skiselev/Proton_Turbo_XT/KiCad/Proton_Turbo_XT-Schematic-1.0.pdf

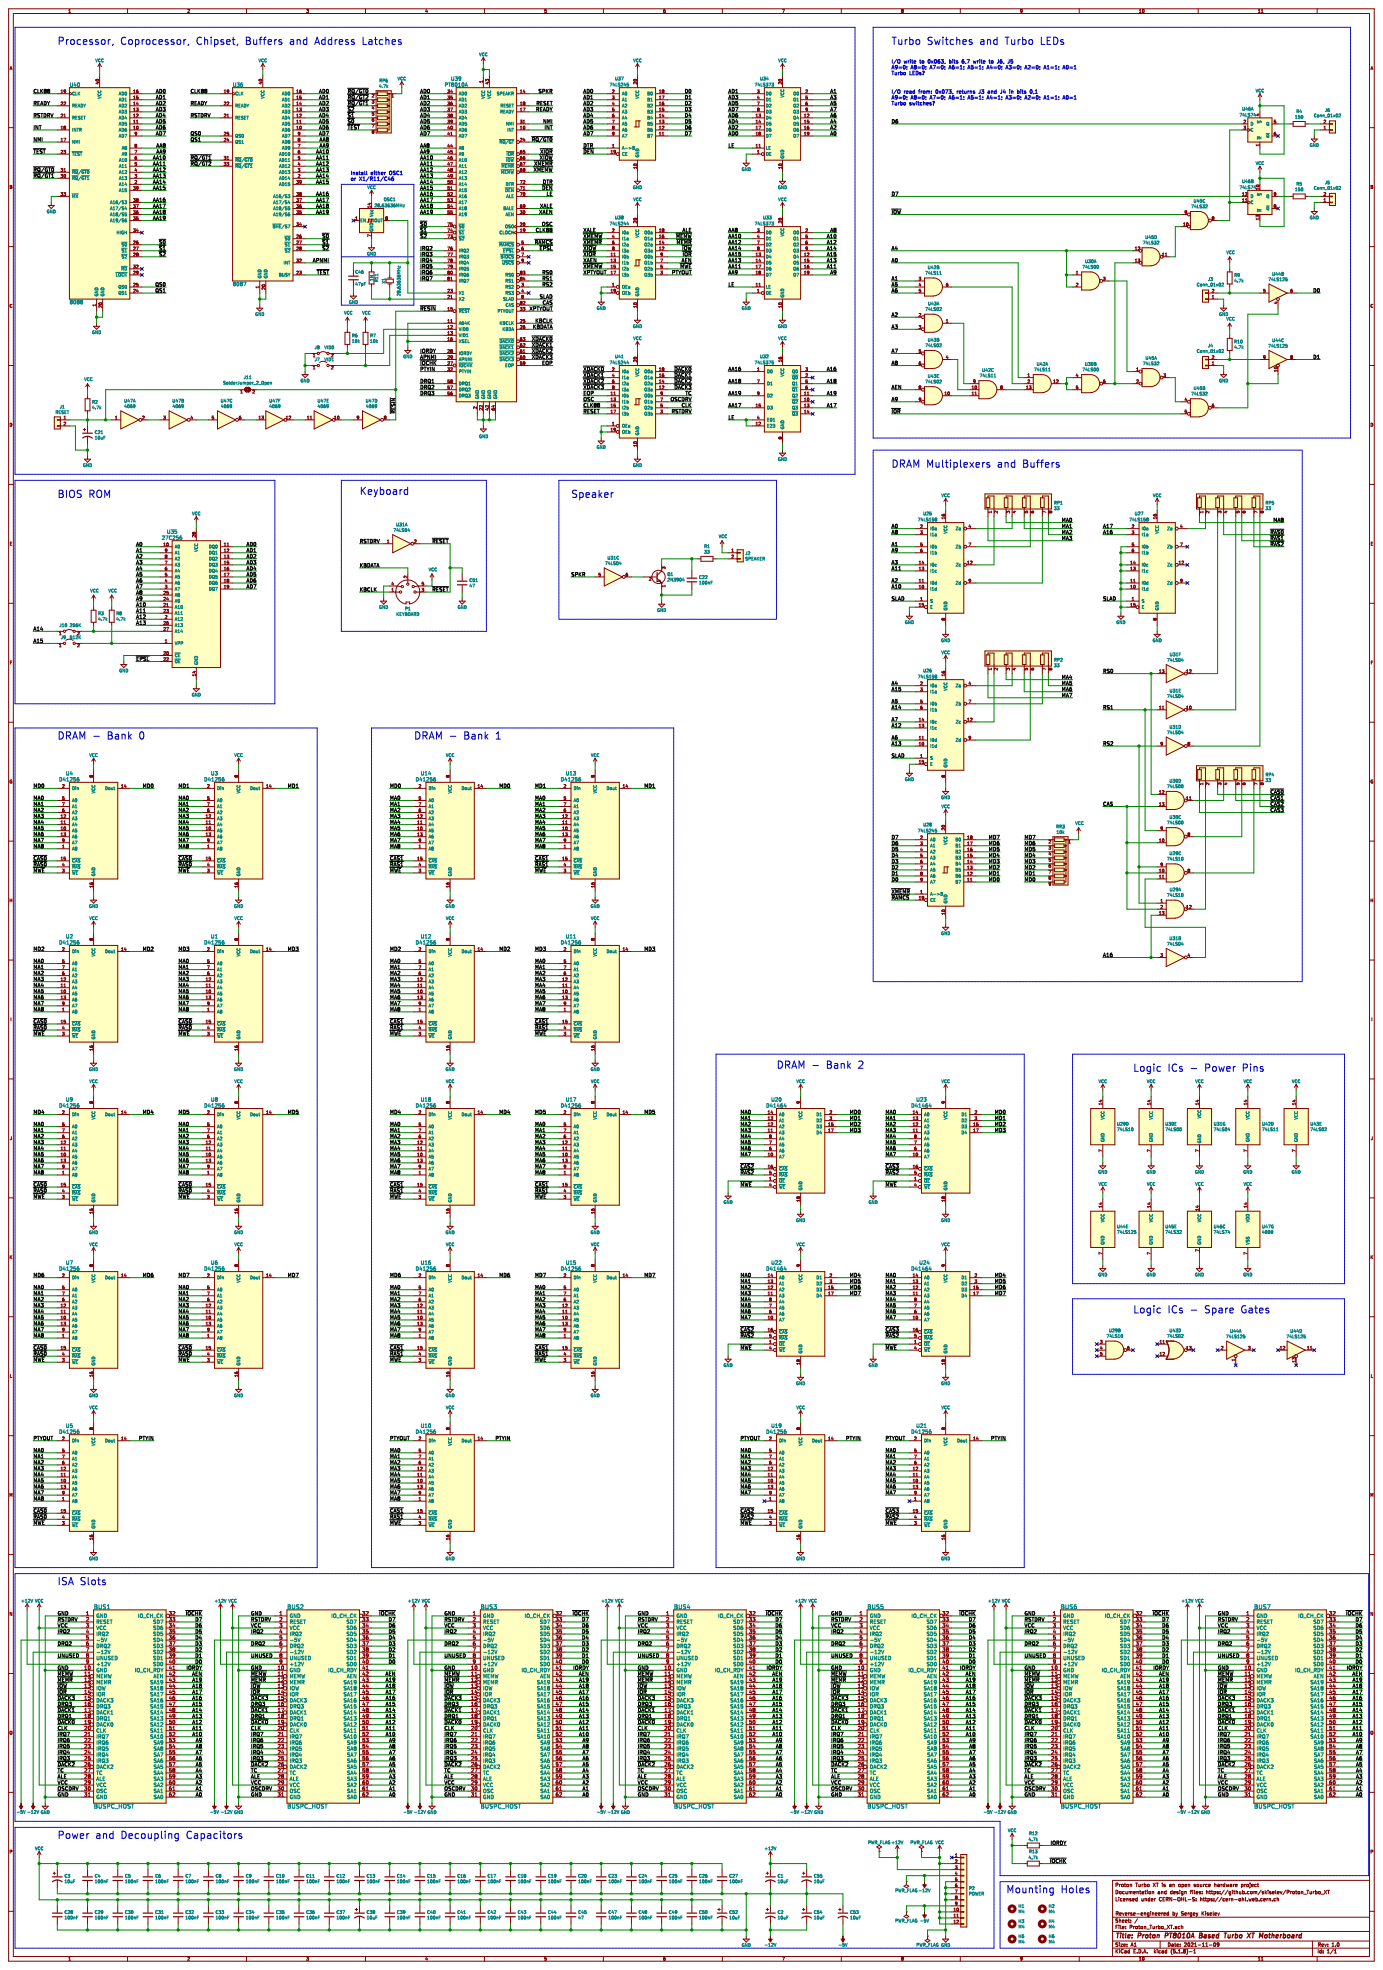
[picture p2: page 1]
