skiselev/Proton_Turbo_XT/KiCad/Proton_Turbo_XT.sch

## KiCad design KiCad/Proton_Turbo_XT.sch (2021-11-10)

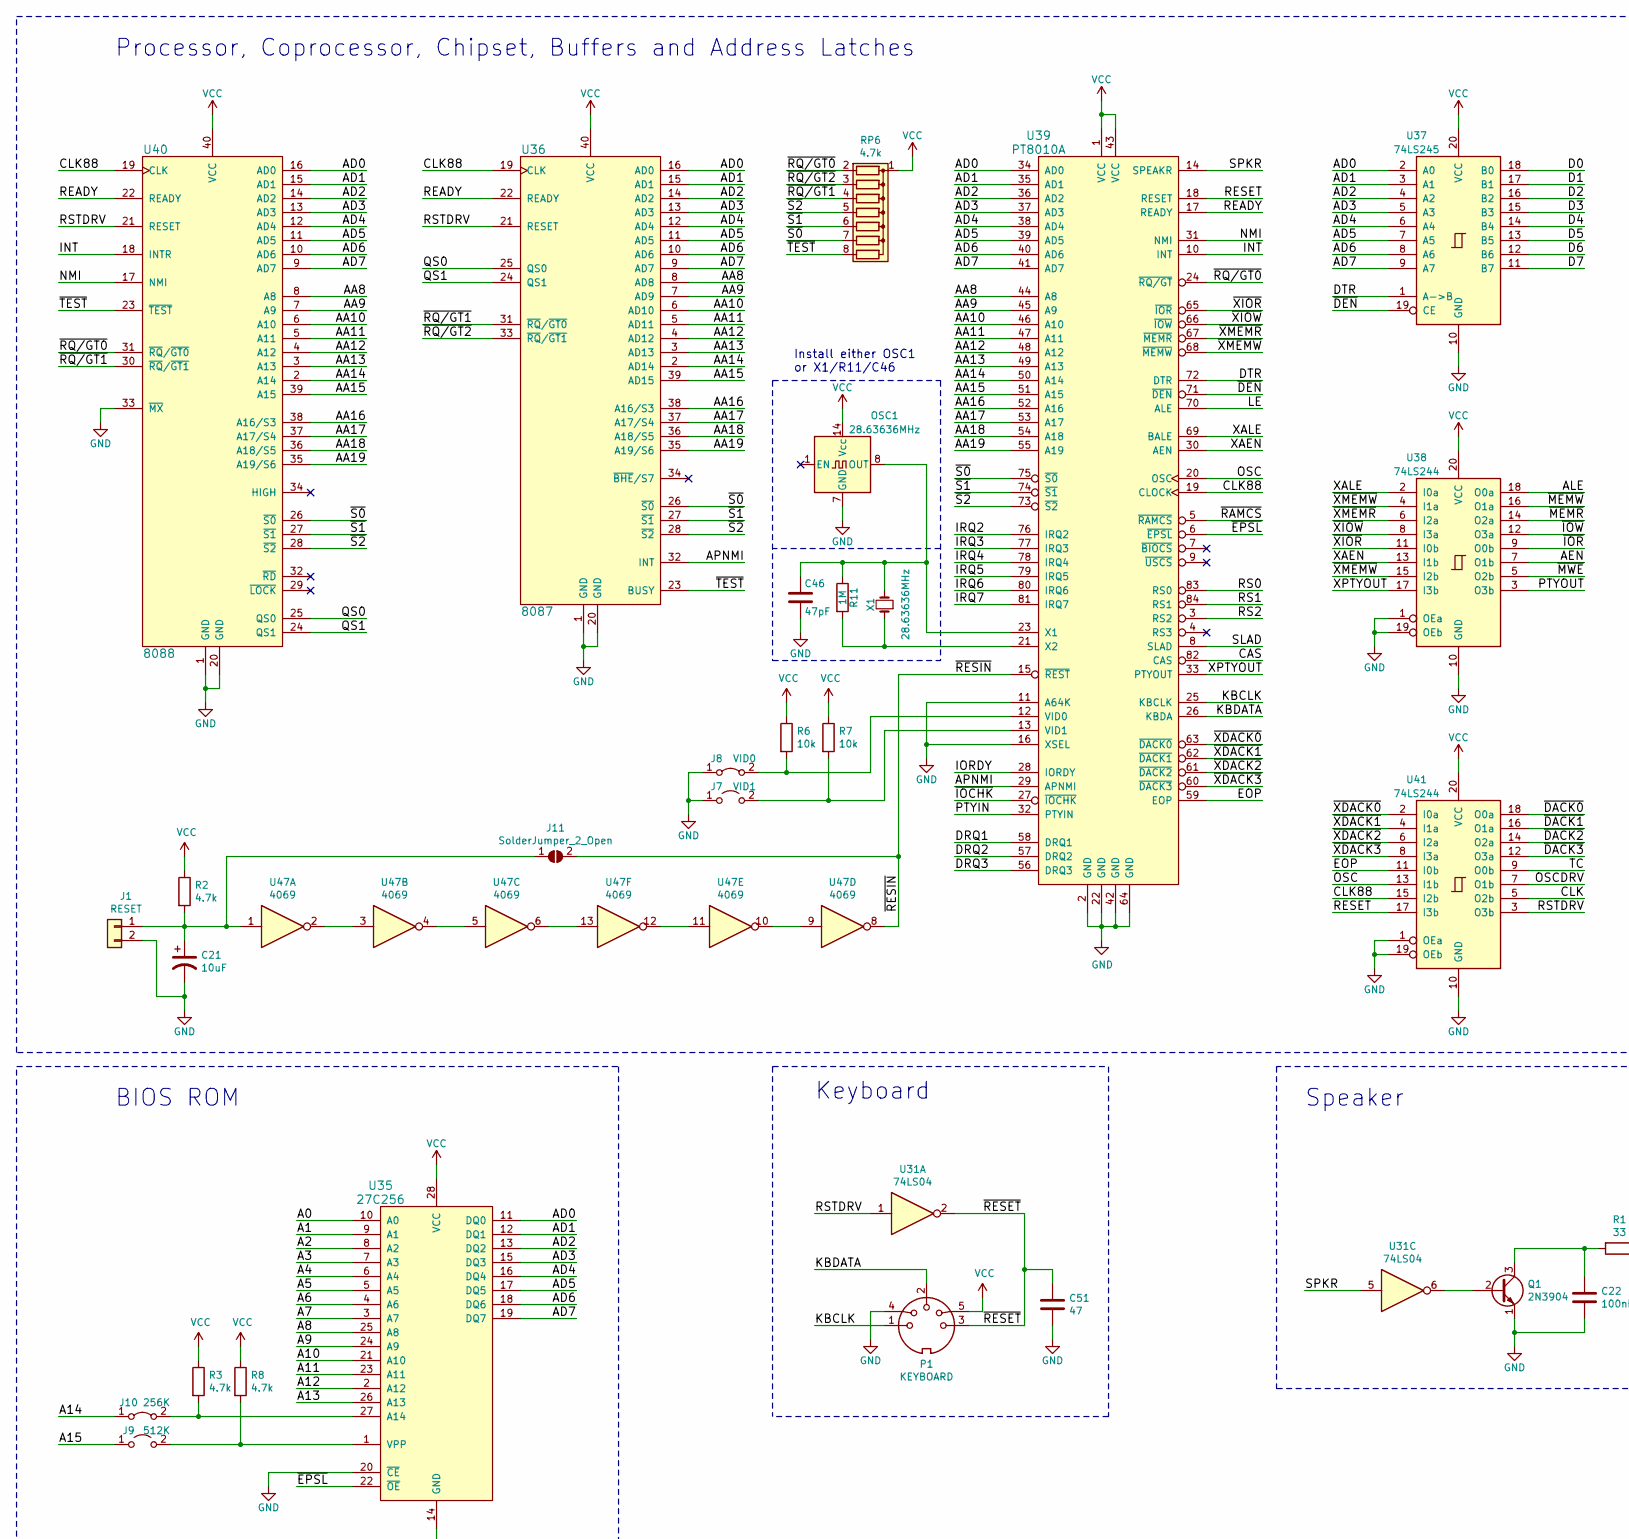
[picture p3: schematic Proton_Turbo_XT.sch, part in row 1, column 1]

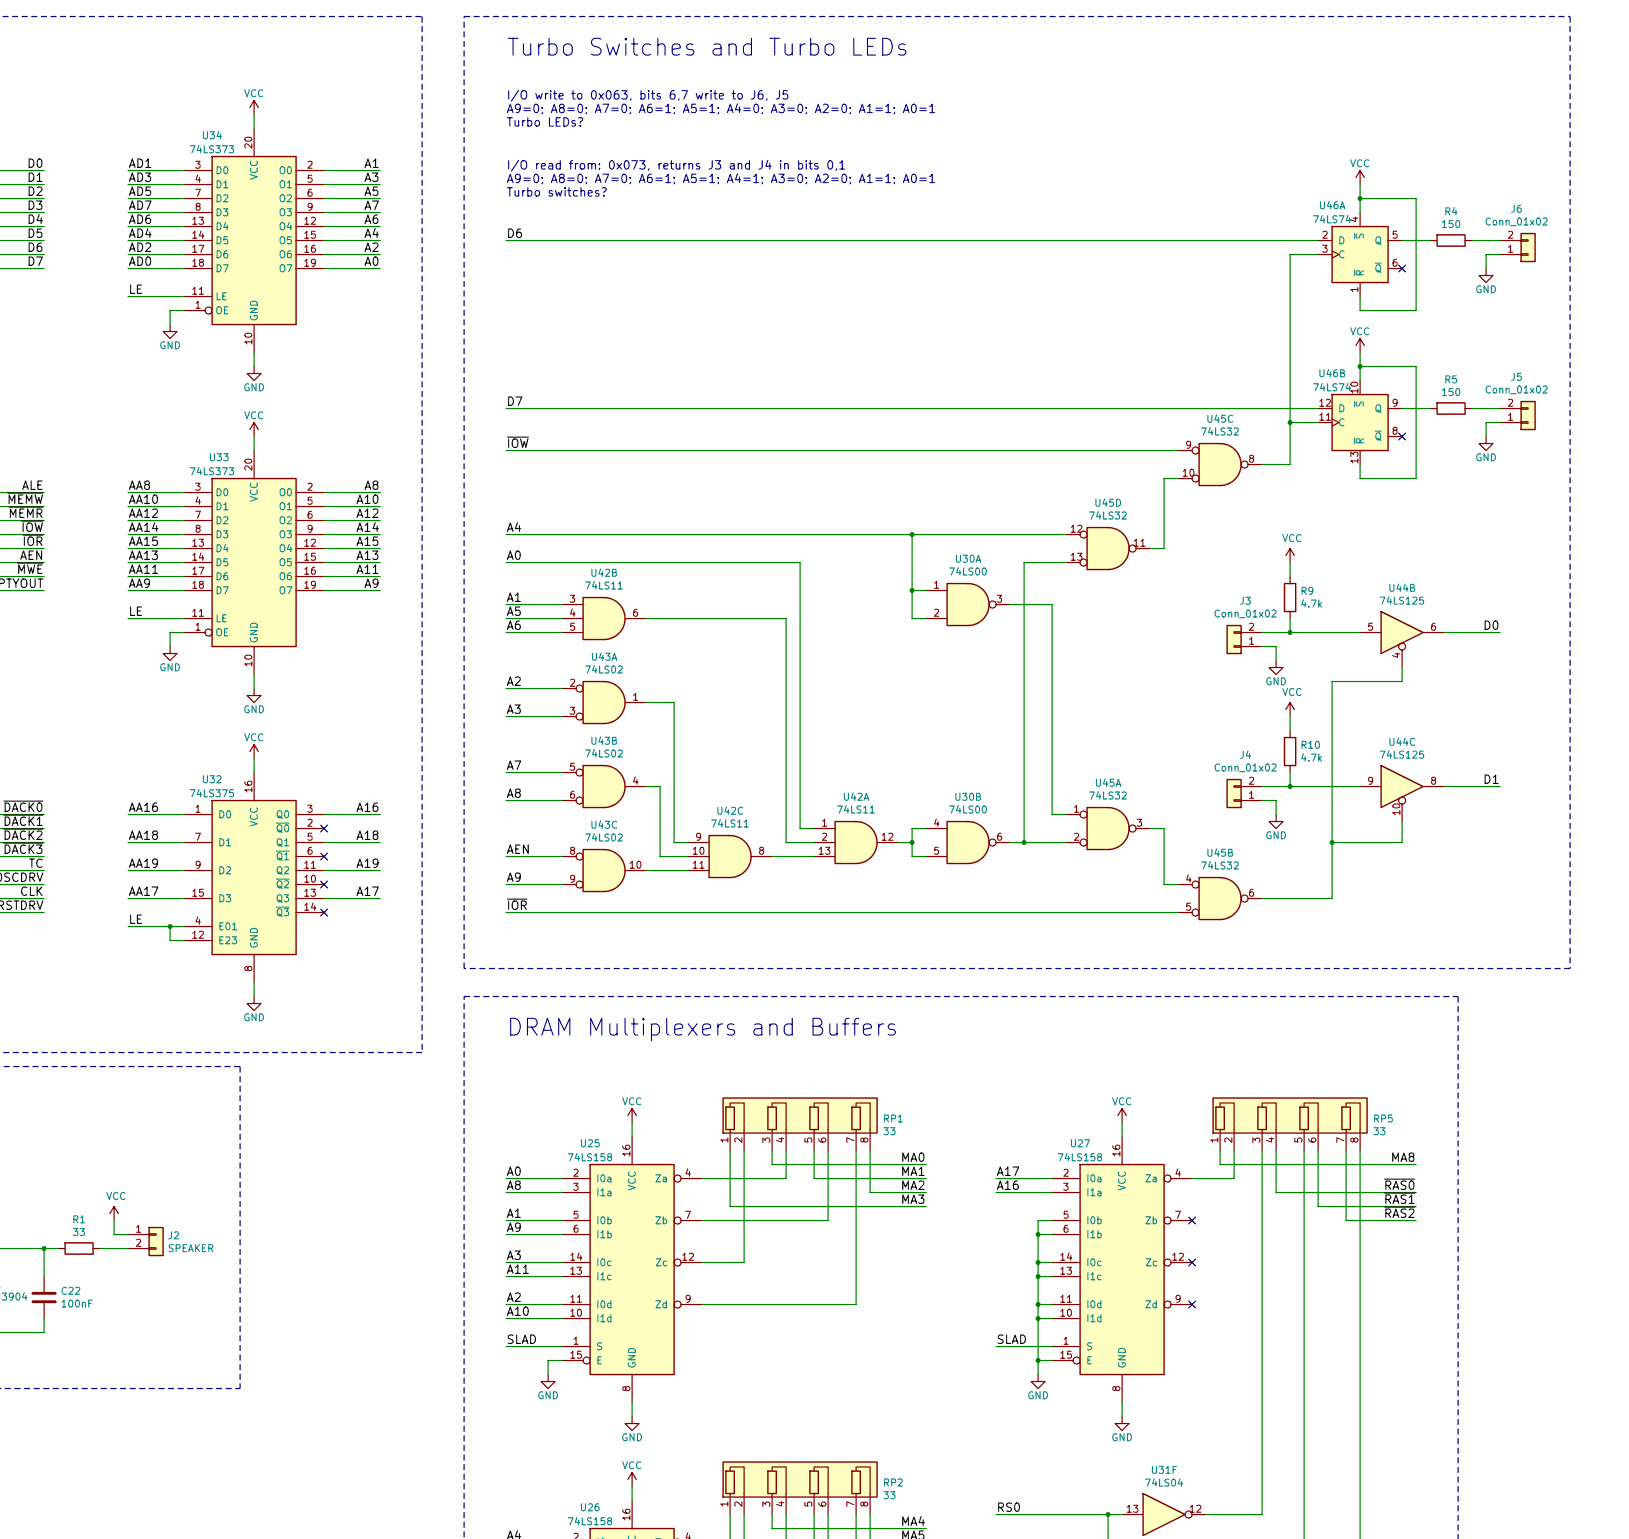
[picture p4: schematic Proton_Turbo_XT.sch, part in row 1, column 2]

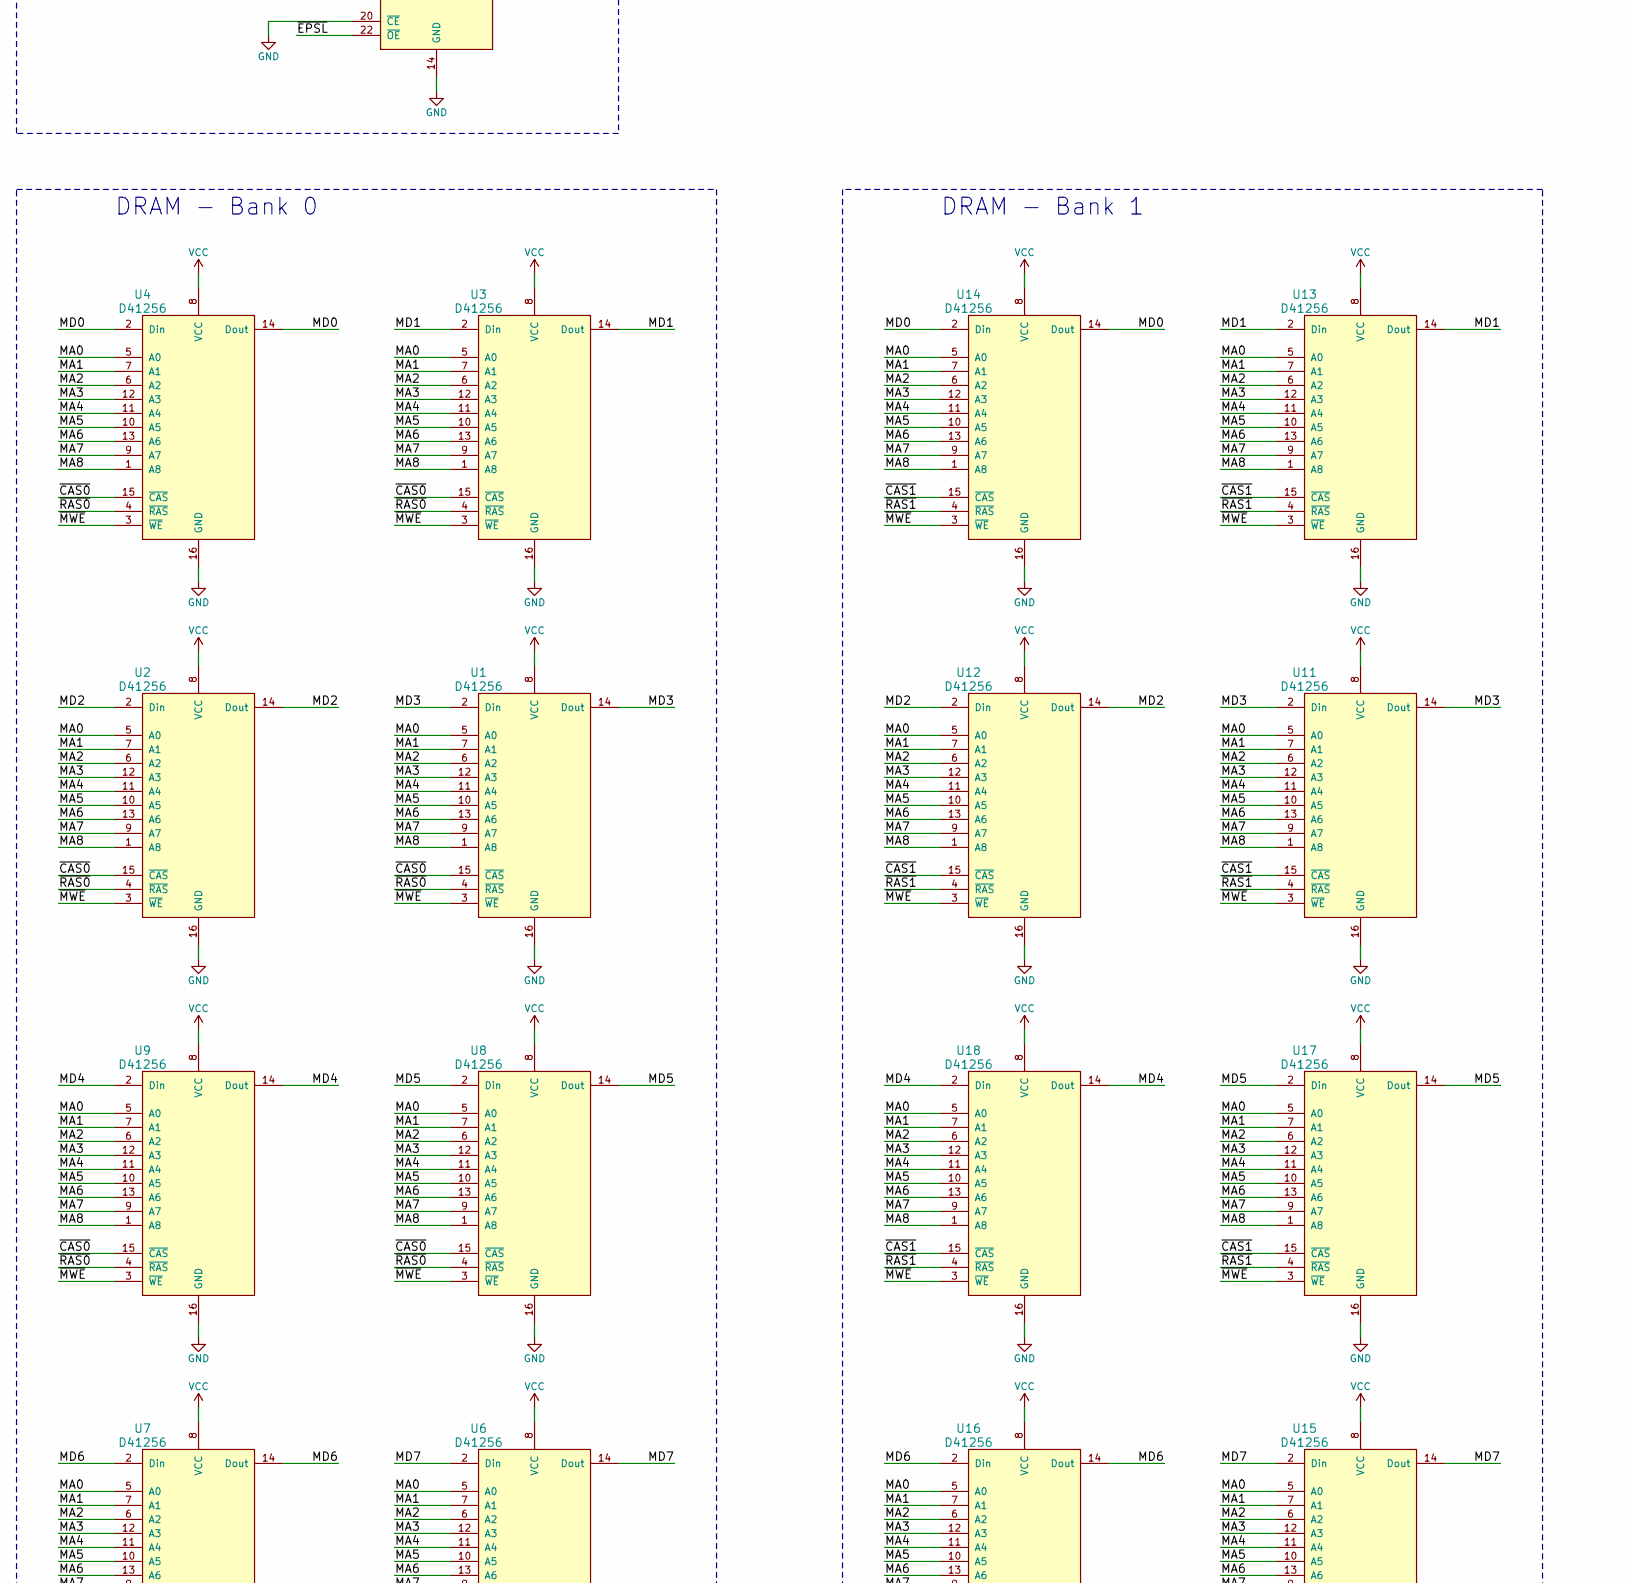
[picture p5: schematic Proton_Turbo_XT.sch, part in row 2, column 1]

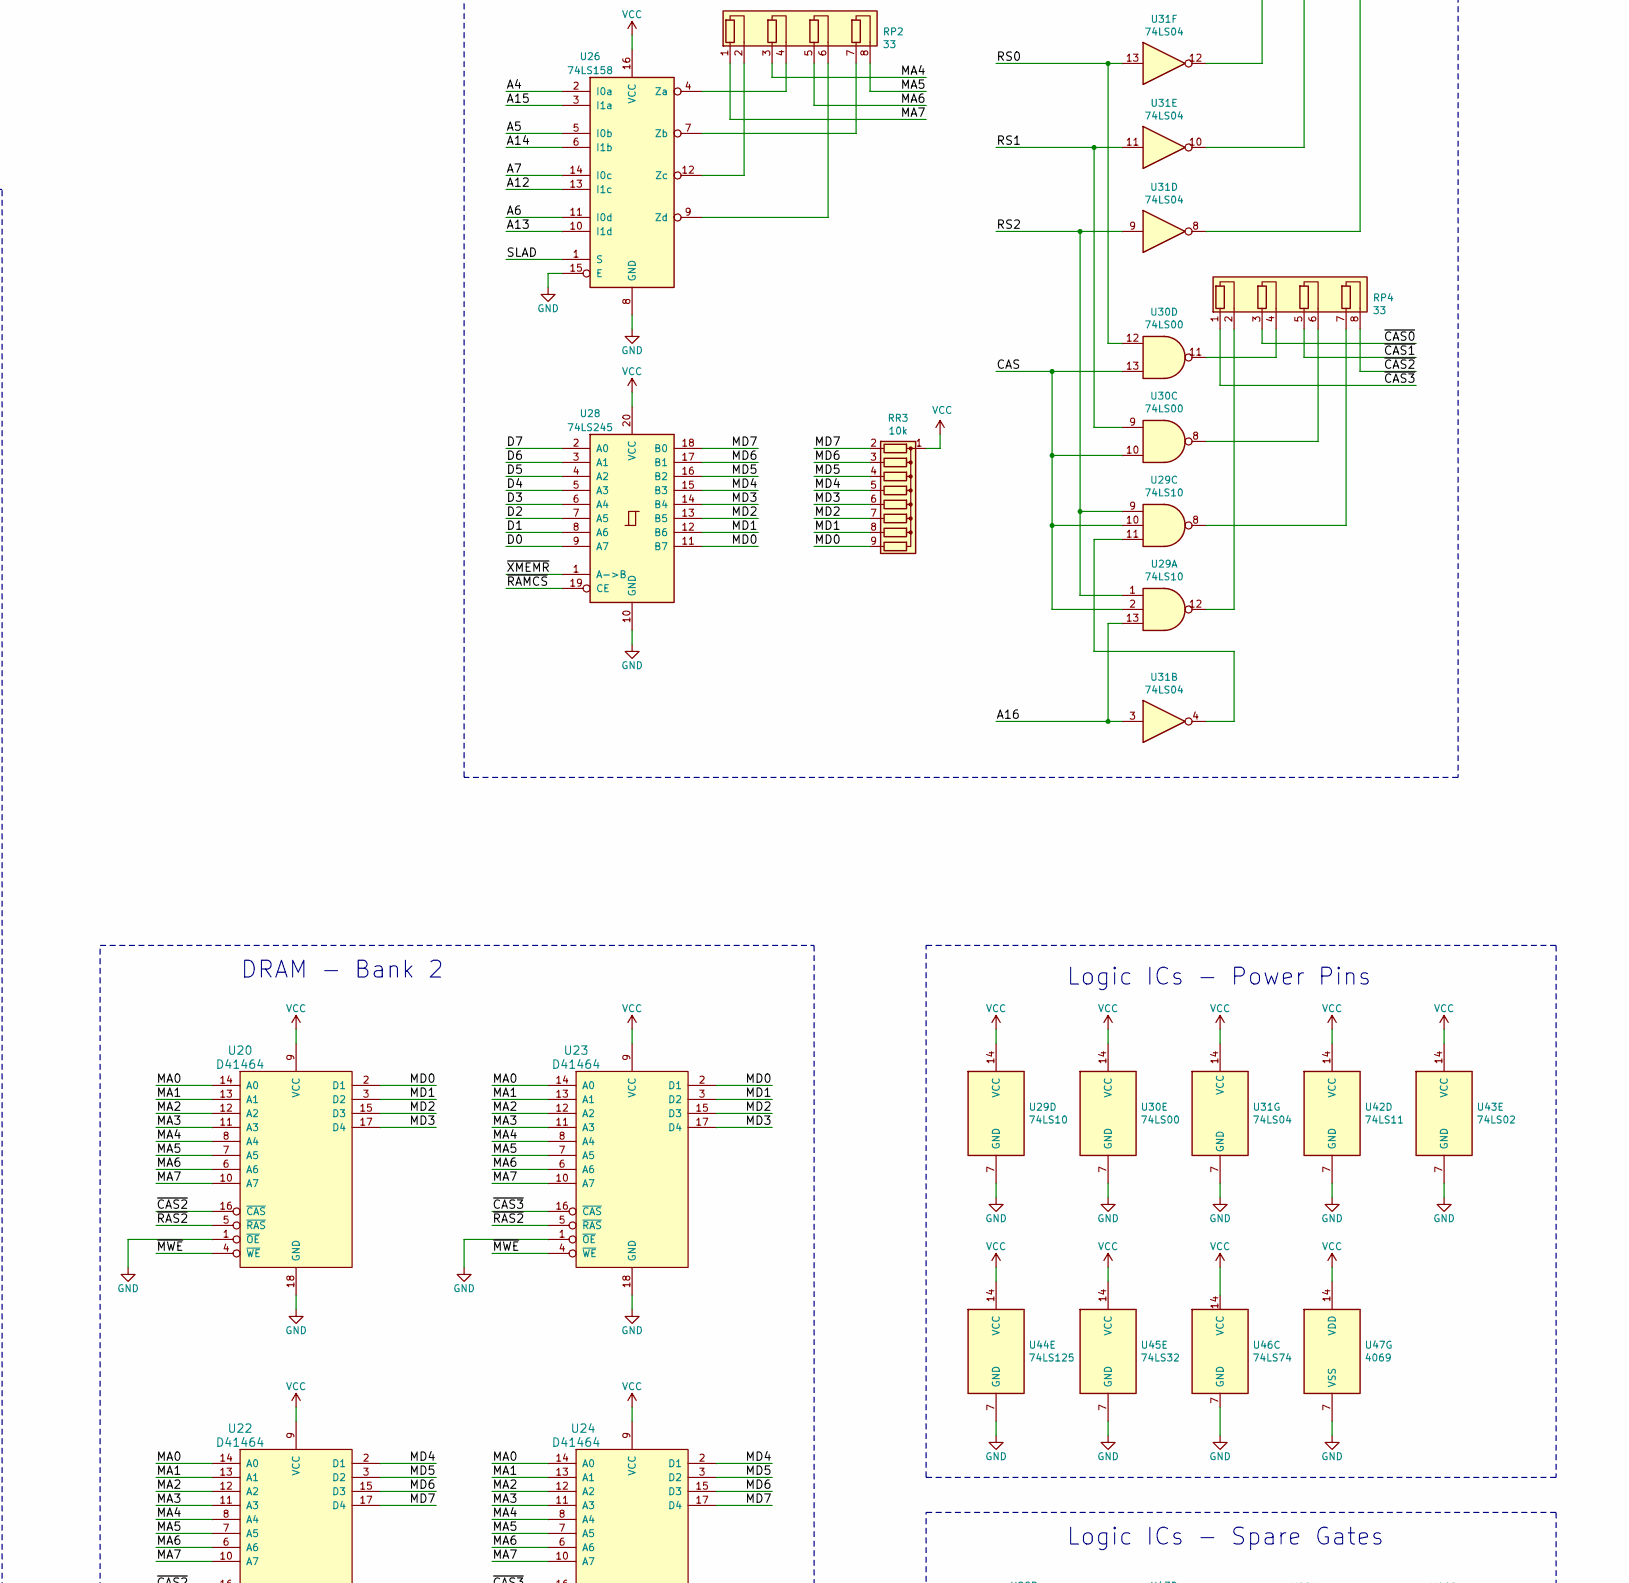
[picture p6: schematic Proton_Turbo_XT.sch, part in row 2, column 2]

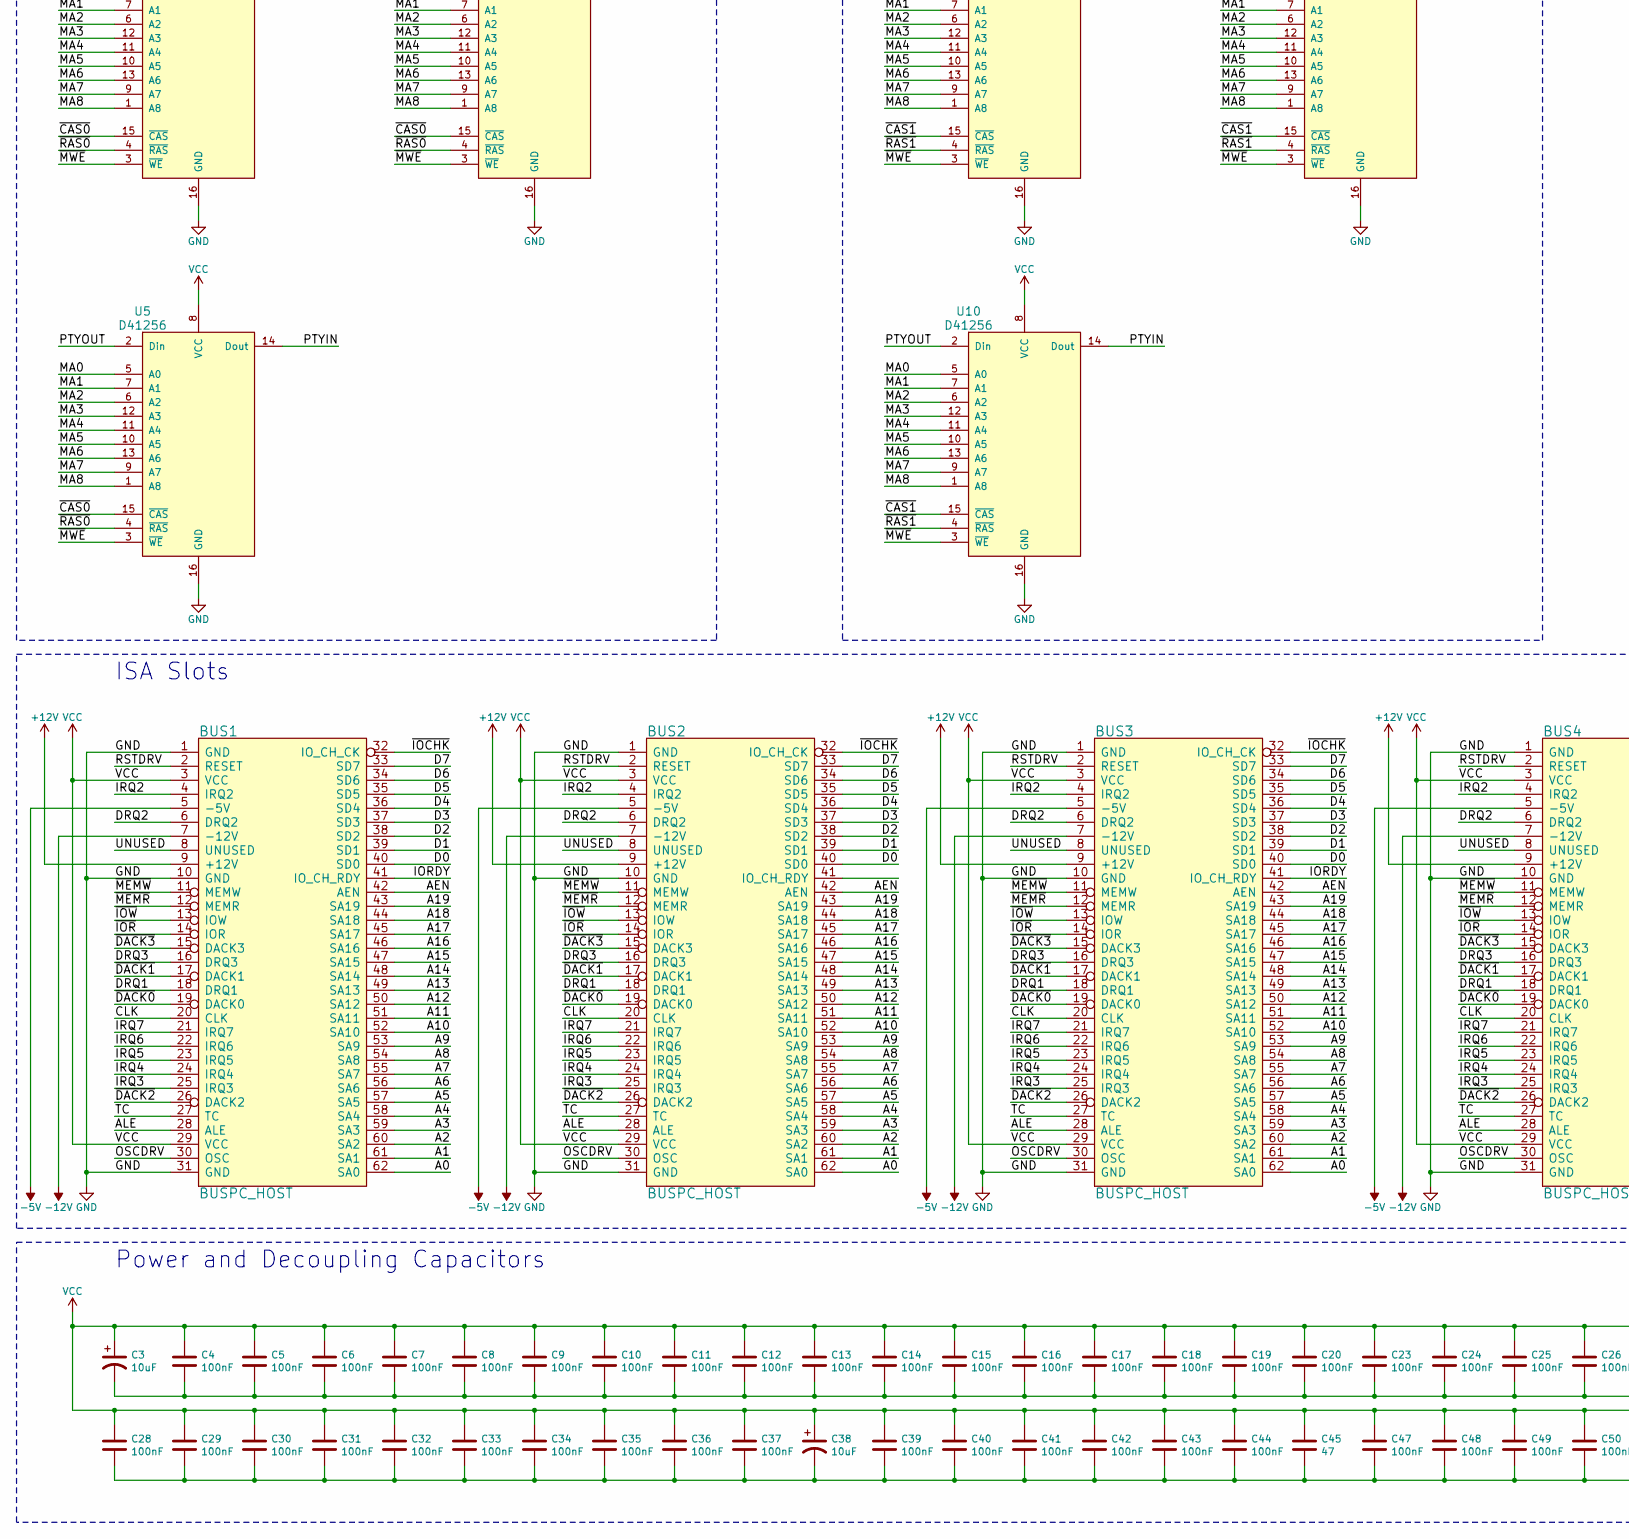
[picture p7: schematic Proton_Turbo_XT.sch, part in row 3, column 1]

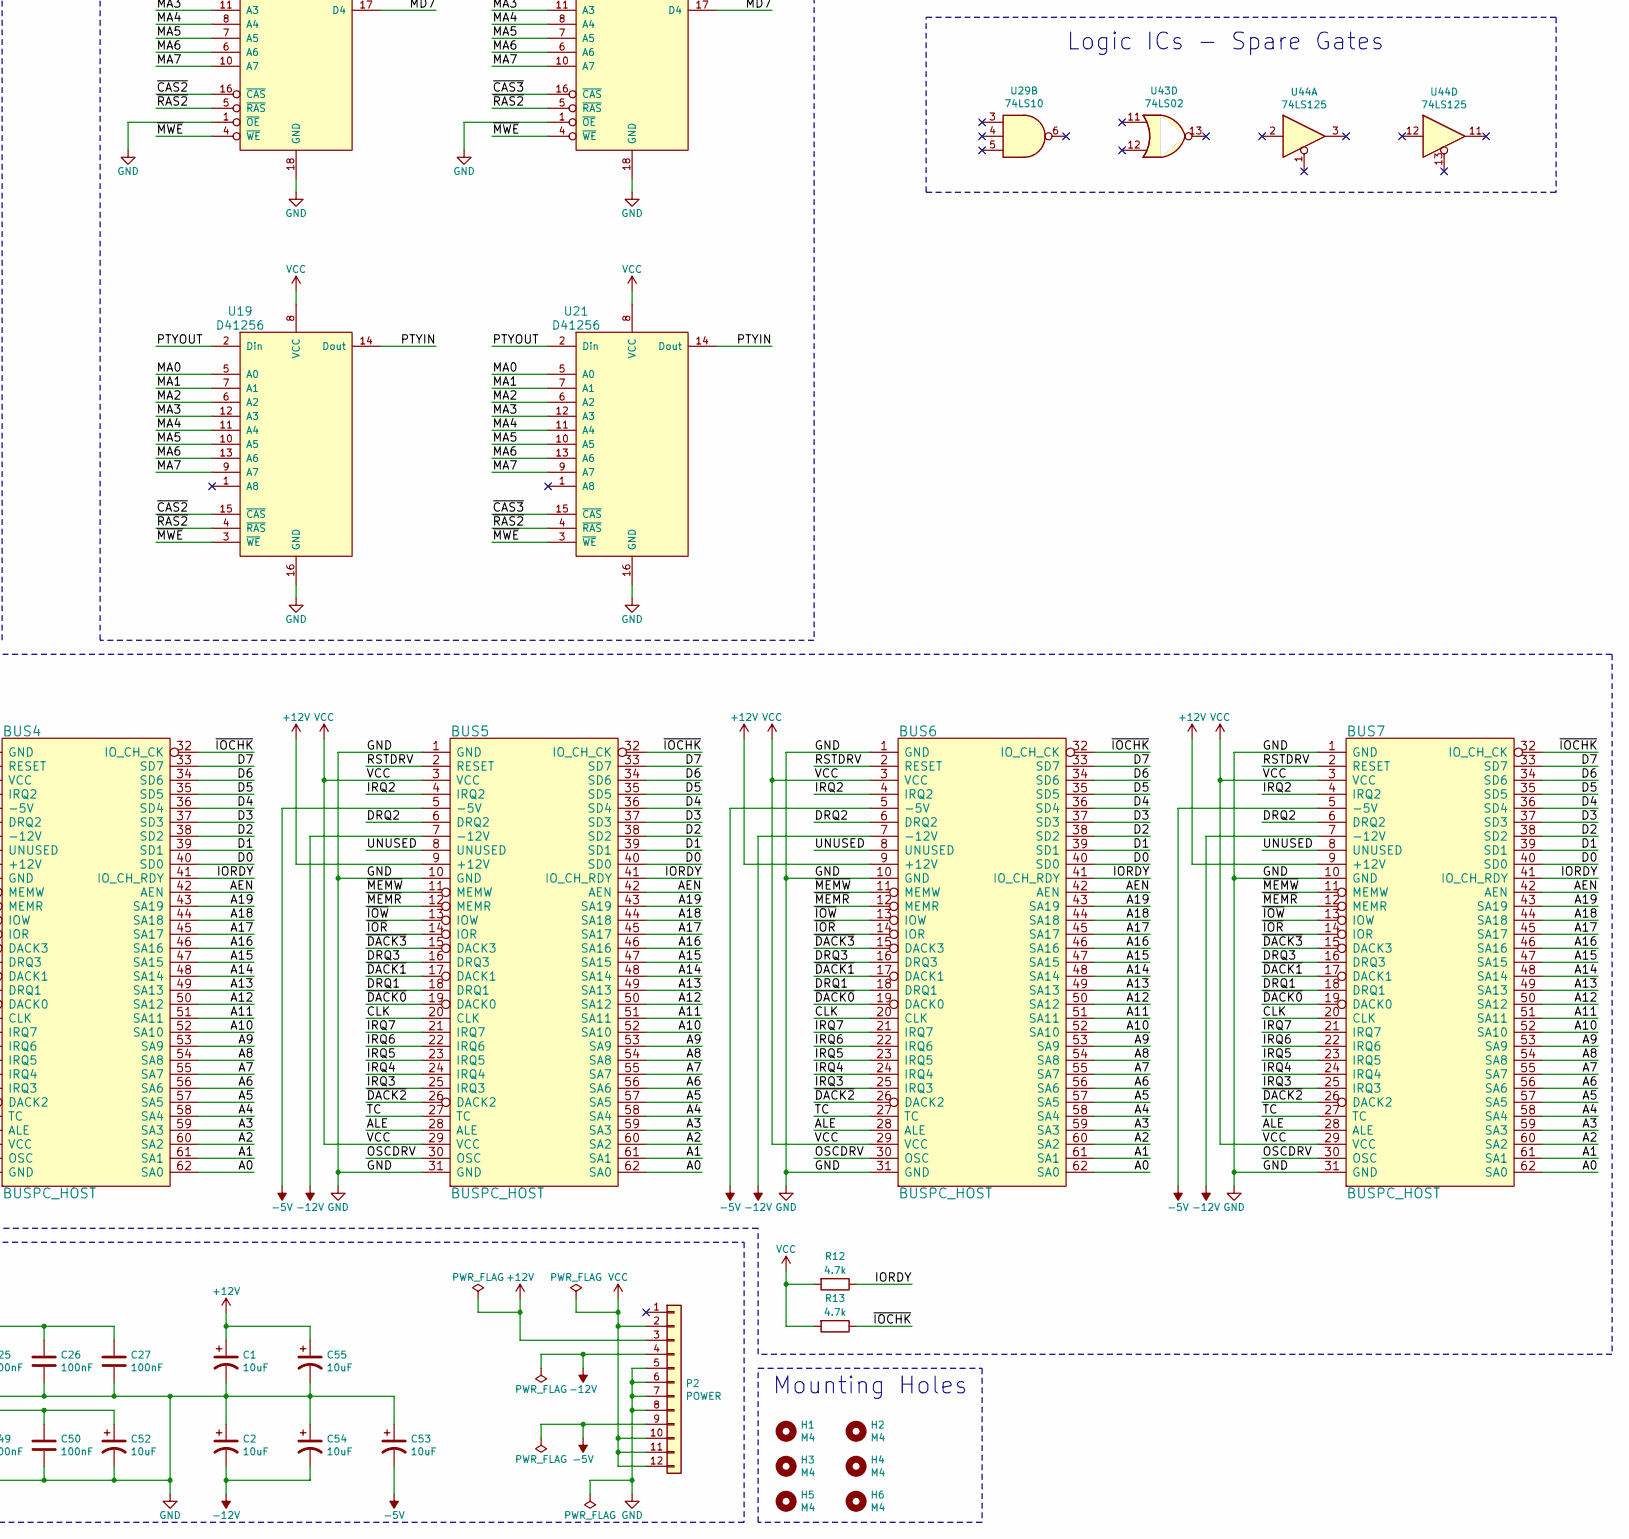
[picture p8: schematic Proton_Turbo_XT.sch, part in row 3, column 2]

Parts:
BUS1, BUS2, BUS3, BUS4, BUS5, BUS6, BUS7: BUSPC_HOST; Conn_Edge_PCB_ISA8
C1, C2, C3, C21, C38, C52, C53, C54, C55: 10uF
C4, C5, C6, C7, C8, C9, C10, C11, C12, C13, C14, C15, C16, C17, C18, C19, C20, C22, C23, C24, C25, C26, C27, C28, C29, C30, C31, C32, C33, C34, C35, C36, C37, C39, C40, C41, C42, C43, C44, C47, C48, C49, C50: 100nF
C45, C51: 47
C46: 47pF; Cap_Cer_508
H1, H2, H3, H4, H5, H6: M4
J1: RESET
J2: SPEAKER
J3, J4, J5, J6: Conn_01x02
J7: VID1
J8: VID0
J9: 512K
J10: 256K
J11: SolderJumper_2_Open
OSC1: 28.63636MHz; Oscillator_DIP-14
P1: KEYBOARD
P2: POWER
Q1: 2N3904; TO-92_Inline
R1: 33
R2, R3, R8, R9, R10, R12, R13: 4.7k
R4, R5: 150
R6, R7: 10k
R11: 1M; Res_762
RP1, RP2, RP4, RP5: 33; R_Array_SIP8
RP6: 4.7k; R_Array_SIP8
RR3: 10k; R_Array_SIP9
U1, U2, U3, U4, U5, U6, U7, U8, U9, U10, U11, U12, U13, U14, U15, U16, U17, U18, U19, U21: D41256
U20, U22, U23, U24: D41464
U25, U26, U27: 74LS158
U28, U37: 74LS245
U29: 74LS10
U30: 74LS00
U31: 74LS04
U32: 74LS375
U33, U34: 74LS373
U35: 27C256
U36: 8087; IC_DIP40_600
U38, U41: 74LS244
U39: PT8010A
U40: 8088; IC_DIP40_600
U42: 74LS11
U43: 74LS02
U44: 74LS125
U45: 74LS32
U46: 74LS74
U47: 4069
X1: 28.63636MHz; Crystal_HC-49U_Vert

Connections:
+12V: BUS1.9 (+12V), BUS2.9 (+12V), BUS3.9 (+12V), BUS4.9 (+12V), BUS5.9 (+12V), BUS6.9 (+12V), BUS7.9 (+12V), C1.1, C55.1, P2.3
-5V: BUS1.5 (-5V), BUS2.5 (-5V), BUS3.5 (-5V), BUS4.5 (-5V), BUS5.5 (-5V), BUS6.5 (-5V), BUS7.5 (-5V), C53.2, P2.9
-12V: BUS1.7 (-12V), BUS2.7 (-12V), BUS3.7 (-12V), BUS4.7 (-12V), BUS5.7 (-12V), BUS6.7 (-12V), BUS7.7 (-12V), C2.2, C54.2, P2.4
A0: BUS1.62 (SA0), BUS2.62 (SA0), BUS3.62 (SA0), BUS4.62 (SA0), BUS5.62 (SA0), BUS6.62 (SA0), BUS7.62 (SA0), U25.2 (I0a), U34.19 (O7), U35.10 (A0), U42.1
A1: BUS1.61 (SA1), BUS2.61 (SA1), BUS3.61 (SA1), BUS4.61 (SA1), BUS5.61 (SA1), BUS6.61 (SA1), BUS7.61 (SA1), U25.5 (I0b), U34.2 (O0), U35.9 (A1), U42.3
A2: BUS1.60 (SA2), BUS2.60 (SA2), BUS3.60 (SA2), BUS4.60 (SA2), BUS5.60 (SA2), BUS6.60 (SA2), BUS7.60 (SA2), U25.11 (I0d), U34.16 (O6), U35.8 (A2), U43.2
A3: BUS1.59 (SA3), BUS2.59 (SA3), BUS3.59 (SA3), BUS4.59 (SA3), BUS5.59 (SA3), BUS6.59 (SA3), BUS7.59 (SA3), U25.14 (I0c), U34.5 (O1), U35.7 (A3), U43.3
A4: BUS1.58 (SA4), BUS2.58 (SA4), BUS3.58 (SA4), BUS4.58 (SA4), BUS5.58 (SA4), BUS6.58 (SA4), BUS7.58 (SA4), U26.2 (I0a), U30.1, U30.2, U34.15 (O5), U35.6 (A4), U45.12
A5: BUS1.57 (SA5), BUS2.57 (SA5), BUS3.57 (SA5), BUS4.57 (SA5), BUS5.57 (SA5), BUS6.57 (SA5), BUS7.57 (SA5), U26.5 (I0b), U34.6 (O2), U35.5 (A5), U42.4
A6: BUS1.56 (SA6), BUS2.56 (SA6), BUS3.56 (SA6), BUS4.56 (SA6), BUS5.56 (SA6), BUS6.56 (SA6), BUS7.56 (SA6), U26.11 (I0d), U34.12 (O4), U35.4 (A6), U42.5
A7: BUS1.55 (SA7), BUS2.55 (SA7), BUS3.55 (SA7), BUS4.55 (SA7), BUS5.55 (SA7), BUS6.55 (SA7), BUS7.55 (SA7), U26.14 (I0c), U34.9 (O3), U35.3 (A7), U43.5
A8: BUS1.54 (SA8), BUS2.54 (SA8), BUS3.54 (SA8), BUS4.54 (SA8), BUS5.54 (SA8), BUS6.54 (SA8), BUS7.54 (SA8), U25.3 (I1a), U33.2 (O0), U35.25 (A8), U43.6
A9: BUS1.53 (SA9), BUS2.53 (SA9), BUS3.53 (SA9), BUS4.53 (SA9), BUS5.53 (SA9), BUS6.53 (SA9), BUS7.53 (SA9), U25.6 (I1b), U33.19 (O7), U35.24 (A9), U43.9
A10: BUS1.52 (SA10), BUS2.52 (SA10), BUS3.52 (SA10), BUS4.52 (SA10), BUS5.52 (SA10), BUS6.52 (SA10), BUS7.52 (SA10), U25.10 (I1d), U33.5 (O1), U35.21 (A10)
A11: BUS1.51 (SA11), BUS2.51 (SA11), BUS3.51 (SA11), BUS4.51 (SA11), BUS5.51 (SA11), BUS6.51 (SA11), BUS7.51 (SA11), U25.13 (I1c), U33.16 (O6), U35.23 (A11)
A12: BUS1.50 (SA12), BUS2.50 (SA12), BUS3.50 (SA12), BUS4.50 (SA12), BUS5.50 (SA12), BUS6.50 (SA12), BUS7.50 (SA12), U26.13 (I1c), U33.6 (O2), U35.2 (A12)
A13: BUS1.49 (SA13), BUS2.49 (SA13), BUS3.49 (SA13), BUS4.49 (SA13), BUS5.49 (SA13), BUS6.49 (SA13), BUS7.49 (SA13), U26.10 (I1d), U33.15 (O5), U35.26 (A13)
A14: BUS1.48 (SA14), BUS2.48 (SA14), BUS3.48 (SA14), BUS4.48 (SA14), BUS5.48 (SA14), BUS6.48 (SA14), BUS7.48 (SA14), J10.1 (A), U26.6 (I1b), U33.9 (O3)
A15: BUS1.47 (SA15), BUS2.47 (SA15), BUS3.47 (SA15), BUS4.47 (SA15), BUS5.47 (SA15), BUS6.47 (SA15), BUS7.47 (SA15), J9.1 (A), U26.3 (I1a), U33.12 (O4)
A16: BUS1.46 (SA16), BUS2.46 (SA16), BUS3.46 (SA16), BUS4.46 (SA16), BUS5.46 (SA16), BUS6.46 (SA16), BUS7.46 (SA16), U27.3 (I1a), U29.13, U31.3, U32.3 (Q0)
A17: BUS1.45 (SA17), BUS2.45 (SA17), BUS3.45 (SA17), BUS4.45 (SA17), BUS5.45 (SA17), BUS6.45 (SA17), BUS7.45 (SA17), U27.2 (I0a), U32.13 (Q3)
A18: BUS1.44 (SA18), BUS2.44 (SA18), BUS3.44 (SA18), BUS4.44 (SA18), BUS5.44 (SA18), BUS6.44 (SA18), BUS7.44 (SA18), U32.5 (Q1)
A19: BUS1.43 (SA19), BUS2.43 (SA19), BUS3.43 (SA19), BUS4.43 (SA19), BUS5.43 (SA19), BUS6.43 (SA19), BUS7.43 (SA19), U32.11 (Q2)
AA8: U33.3 (D0), U36.8 (AD8), U39.44 (A8), U40.8 (A8)
AA9: U33.18 (D7), U36.7 (AD9), U39.45 (A9), U40.7 (A9)
AA10: U33.4 (D1), U36.6 (AD10), U39.46 (A10), U40.6 (A10)
AA11: U33.17 (D6), U36.5 (AD11), U39.47 (A11), U40.5 (A11)
AA12: U33.7 (D2), U36.4 (AD12), U39.48 (A12), U40.4 (A12)
AA13: U33.14 (D5), U36.3 (AD13), U39.49 (A13), U40.3 (A13)
AA14: U33.8 (D3), U36.2 (AD14), U39.50 (A14), U40.2 (A14)
AA15: U33.13 (D4), U36.39 (AD15), U39.51 (A15), U40.39 (A15)
AA16: U32.1 (D0), U36.38 (A16/S3), U39.52 (A16), U40.38 (A16/S3)
AA17: U32.15 (D3), U36.37 (A17/S4), U39.53 (A17), U40.37 (A17/S4)
AA18: U32.7 (D1), U36.36 (A18/S5), U39.54 (A18), U40.36 (A18/S5)
AA19: U32.9 (D2), U36.35 (A19/S6), U39.55 (A19), U40.35 (A19/S6)
AD0: U34.18 (D7), U35.11 (DQ0), U36.16 (AD0), U37.2 (A0), U39.34 (AD0), U40.16 (AD0)
AD1: U34.3 (D0), U35.12 (DQ1), U36.15 (AD1), U37.3 (A1), U39.35 (AD1), U40.15 (AD1)
AD2: U34.17 (D6), U35.13 (DQ2), U36.14 (AD2), U37.4 (A2), U39.36 (AD2), U40.14 (AD2)
AD3: U34.4 (D1), U35.15 (DQ3), U36.13 (AD3), U37.5 (A3), U39.37 (AD3), U40.13 (AD3)
AD4: U34.14 (D5), U35.16 (DQ4), U36.12 (AD4), U37.6 (A4), U39.38 (AD4), U40.12 (AD4)
AD5: U34.7 (D2), U35.17 (DQ5), U36.11 (AD5), U37.7 (A5), U39.39 (AD5), U40.11 (AD5)
AD6: U34.13 (D4), U35.18 (DQ6), U36.10 (AD6), U37.8 (A6), U39.40 (AD6), U40.10 (AD6)
AD7: U34.8 (D3), U35.19 (DQ7), U36.9 (AD7), U37.9 (A7), U39.41 (AD7), U40.9 (AD7)
AEN: BUS1.42 (AEN), BUS2.42 (AEN), BUS3.42 (AEN), BUS4.42 (AEN), BUS5.42 (AEN), BUS6.42 (AEN), BUS7.42 (AEN), U38.7 (O1b), U43.8
ALE: BUS1.28 (ALE), BUS2.28 (ALE), BUS3.28 (ALE), BUS4.28 (ALE), BUS5.28 (ALE), BUS6.28 (ALE), BUS7.28 (ALE), U38.18 (O0a)
APNMI: U36.32 (INT), U39.29 (APNMI)
CAS: U29.2, U29.10, U30.10, U30.13, U39.82 (CAS)
CLK: BUS1.20 (CLK), BUS2.20 (CLK), BUS3.20 (CLK), BUS4.20 (CLK), BUS5.20 (CLK), BUS6.20 (CLK), BUS7.20 (CLK), U41.5 (O2b)
CLK88: U36.19 (CLK), U39.19 (CLOCK), U40.19 (CLK), U41.15 (I2b)
D0: BUS1.40 (SD0), BUS2.40 (SD0), BUS3.40 (SD0), BUS4.40 (SD0), BUS5.40 (SD0), BUS6.40 (SD0), BUS7.40 (SD0), U28.9 (A7), U37.18 (B0), U44.6
D1: BUS1.39 (SD1), BUS2.39 (SD1), BUS3.39 (SD1), BUS4.39 (SD1), BUS5.39 (SD1), BUS6.39 (SD1), BUS7.39 (SD1), U28.8 (A6), U37.17 (B1), U44.8
D2: BUS1.38 (SD2), BUS2.38 (SD2), BUS3.38 (SD2), BUS4.38 (SD2), BUS5.38 (SD2), BUS6.38 (SD2), BUS7.38 (SD2), U28.7 (A5), U37.16 (B2)
D3: BUS1.37 (SD3), BUS2.37 (SD3), BUS3.37 (SD3), BUS4.37 (SD3), BUS5.37 (SD3), BUS6.37 (SD3), BUS7.37 (SD3), U28.6 (A4), U37.15 (B3)
D4: BUS1.36 (SD4), BUS2.36 (SD4), BUS3.36 (SD4), BUS4.36 (SD4), BUS5.36 (SD4), BUS6.36 (SD4), BUS7.36 (SD4), U28.5 (A3), U37.14 (B4)
D5: BUS1.35 (SD5), BUS2.35 (SD5), BUS3.35 (SD5), BUS4.35 (SD5), BUS5.35 (SD5), BUS6.35 (SD5), BUS7.35 (SD5), U28.4 (A2), U37.13 (B5)
D6: BUS1.34 (SD6), BUS2.34 (SD6), BUS3.34 (SD6), BUS4.34 (SD6), BUS5.34 (SD6), BUS6.34 (SD6), BUS7.34 (SD6), U28.3 (A1), U37.12 (B6), U46.2 (D)
D7: BUS1.33 (SD7), BUS2.33 (SD7), BUS3.33 (SD7), BUS4.33 (SD7), BUS5.33 (SD7), BUS6.33 (SD7), BUS7.33 (SD7), U28.2 (A0), U37.11 (B7), U46.12 (D)
DRQ1: BUS1.18 (DRQ1), BUS2.18 (DRQ1), BUS3.18 (DRQ1), BUS4.18 (DRQ1), BUS5.18 (DRQ1), BUS6.18 (DRQ1), BUS7.18 (DRQ1), U39.58 (DRQ1)
DRQ2: BUS1.6 (DRQ2), BUS2.6 (DRQ2), BUS3.6 (DRQ2), BUS4.6 (DRQ2), BUS5.6 (DRQ2), BUS6.6 (DRQ2), BUS7.6 (DRQ2), U39.57 (DRQ2)
DRQ3: BUS1.16 (DRQ3), BUS2.16 (DRQ3), BUS3.16 (DRQ3), BUS4.16 (DRQ3), BUS5.16 (DRQ3), BUS6.16 (DRQ3), BUS7.16 (DRQ3), U39.56 (DRQ3)
DTR: U37.1 (A->B), U39.72 (DTR)
EOP: U39.59 (EOP), U41.11 (I0b)
GND: BUS1.1 (GND), BUS1.10 (GND), BUS1.31 (GND), BUS2.1 (GND), BUS2.10 (GND), BUS2.31 (GND), BUS3.1 (GND), BUS3.10 (GND), BUS3.31 (GND), BUS4.1 (GND), BUS4.10 (GND), BUS4.31 (GND), BUS5.1 (GND), BUS5.10 (GND), BUS5.31 (GND), BUS6.1 (GND), BUS6.10 (GND), BUS6.31 (GND), BUS7.1 (GND), BUS7.10 (GND), BUS7.31 (GND), C1.2, C2.1, C3.2, C4.2, C5.2, C6.2, C7.2, C8.2, C9.2, C10.2, C11.2, C12.2, C13.2, C14.2, C15.2, C16.2, C17.2, C18.2, C19.2, C20.2, C21.2, C22.2, C23.2, C24.2, C25.2, C26.2, C27.2, C28.2, C29.2, C30.2, C31.2, C32.2, C33.2, C34.2, C35.2, C36.2, C37.2, C38.2, C39.2, C40.2, C41.2, C42.2, C43.2, C44.2, C45.2, C46.2, C47.2, C48.2, C49.2, C50.2, C51.2, C52.2, C53.1, C54.1, C55.2, J1.2, J3.1, J4.1, J5.1, J6.1, J7.1 (A), J8.1 (A), OSC1.7 (GND), P1.4, P2.5, P2.6, P2.7, P2.8, Q1.1 (E), U1.16 (GND), U2.16 (GND), U3.16 (GND), U4.16 (GND), U5.16 (GND), U6.16 (GND), U7.16 (GND), U8.16 (GND), U9.16 (GND), U10.16 (GND), U11.16 (GND), U12.16 (GND), U13.16 (GND), U14.16 (GND), U15.16 (GND), U16.16 (GND), U17.16 (GND), U18.16 (GND), U19.16 (GND), U20.1 (~OE), U20.18 (GND), U21.16 (GND), U22.1 (~OE), U22.18 (GND), U23.1 (~OE), U23.18 (GND), U24.1 (~OE), U24.18 (GND), U25.8 (GND), U25.15 (E), U26.8 (GND), U26.15 (E), U27.5 (I0b), U27.6 (I1b), U27.8 (GND), U27.10 (I1d), U27.11 (I0d), U27.13 (I1c), U27.14 (I0c), U27.15 (E), U28.10 (GND), U29.7 (GND), U30.7 (GND), U31.7 (GND), U32.8 (GND), U33.1 (OE), U33.10 (GND), U34.1 (OE), U34.10 (GND), U35.14 (GND), U35.20 (~CE), U36.1 (GND), U36.20 (GND), U37.10 (GND), U38.1 (OEa), U38.10 (GND), U38.19 (OEb), U39.2 (GND), U39.11 (A64K), U39.16 (XSEL), U39.22 (GND), U39.42 (GND), U39.64 (GND), U40.1 (GND), U40.20 (GND), U40.33 (~MX), U41.1 (OEa), U41.10 (GND), U41.19 (OEb), U42.7 (GND), U43.7 (GND), U44.7 (GND), U45.7 (GND), U46.7 (GND), U47.7 (VSS)
INT: U39.10 (INT), U40.18 (INTR)
IORDY: BUS1.41 (IO_CH_RDY), BUS3.41 (IO_CH_RDY), BUS4.41 (IO_CH_RDY), BUS5.41 (IO_CH_RDY), BUS6.41 (IO_CH_RDY), BUS7.41 (IO_CH_RDY), R12.1, U39.28 (IORDY)
IRQ2: BUS1.4 (IRQ2), BUS2.4 (IRQ2), BUS3.4 (IRQ2), BUS4.4 (IRQ2), BUS5.4 (IRQ2), BUS6.4 (IRQ2), BUS7.4 (IRQ2), U39.76 (IRQ2)
IRQ3: BUS1.25 (IRQ3), BUS2.25 (IRQ3), BUS3.25 (IRQ3), BUS4.25 (IRQ3), BUS5.25 (IRQ3), BUS6.25 (IRQ3), BUS7.25 (IRQ3), U39.77 (IRQ3)
IRQ4: BUS1.24 (IRQ4), BUS2.24 (IRQ4), BUS3.24 (IRQ4), BUS4.24 (IRQ4), BUS5.24 (IRQ4), BUS6.24 (IRQ4), BUS7.24 (IRQ4), U39.78 (IRQ4)
IRQ5: BUS1.23 (IRQ5), BUS2.23 (IRQ5), BUS3.23 (IRQ5), BUS4.23 (IRQ5), BUS5.23 (IRQ5), BUS6.23 (IRQ5), BUS7.23 (IRQ5), U39.79 (IRQ5)
IRQ6: BUS1.22 (IRQ6), BUS2.22 (IRQ6), BUS3.22 (IRQ6), BUS4.22 (IRQ6), BUS5.22 (IRQ6), BUS6.22 (IRQ6), BUS7.22 (IRQ6), U39.80 (IRQ6)
IRQ7: BUS1.21 (IRQ7), BUS2.21 (IRQ7), BUS3.21 (IRQ7), BUS4.21 (IRQ7), BUS5.21 (IRQ7), BUS6.21 (IRQ7), BUS7.21 (IRQ7), U39.81 (IRQ7)
KBCLK: P1.1, U39.25 (KBCLK)
KBDATA: P1.2, U39.26 (KBDA)
LE: U32.4 (E01), U32.12 (E23), U33.11 (LE), U34.11 (LE), U39.70 (ALE)
MA0: RP1.3 (R2.1), U1.5 (A0), U2.5 (A0), U3.5 (A0), U4.5 (A0), U5.5 (A0), U6.5 (A0), U7.5 (A0), U8.5 (A0), U9.5 (A0), U10.5 (A0), U11.5 (A0), U12.5 (A0), U13.5 (A0), U14.5 (A0), U15.5 (A0), U16.5 (A0), U17.5 (A0), U18.5 (A0), U19.5 (A0), U20.14 (A0), U21.5 (A0), U22.14 (A0), U23.14 (A0), U24.14 (A0)
MA1: RP1.5 (R3.1), U1.7 (A1), U2.7 (A1), U3.7 (A1), U4.7 (A1), U5.7 (A1), U6.7 (A1), U7.7 (A1), U8.7 (A1), U9.7 (A1), U10.7 (A1), U11.7 (A1), U12.7 (A1), U13.7 (A1), U14.7 (A1), U15.7 (A1), U16.7 (A1), U17.7 (A1), U18.7 (A1), U19.7 (A1), U20.13 (A1), U21.7 (A1), U22.13 (A1), U23.13 (A1), U24.13 (A1)
MA2: RP1.8 (R4.2), U1.6 (A2), U2.6 (A2), U3.6 (A2), U4.6 (A2), U5.6 (A2), U6.6 (A2), U7.6 (A2), U8.6 (A2), U9.6 (A2), U10.6 (A2), U11.6 (A2), U12.6 (A2), U13.6 (A2), U14.6 (A2), U15.6 (A2), U16.6 (A2), U17.6 (A2), U18.6 (A2), U19.6 (A2), U20.12 (A2), U21.6 (A2), U22.12 (A2), U23.12 (A2), U24.12 (A2)
MA3: RP1.1 (R1.1), U1.12 (A3), U2.12 (A3), U3.12 (A3), U4.12 (A3), U5.12 (A3), U6.12 (A3), U7.12 (A3), U8.12 (A3), U9.12 (A3), U10.12 (A3), U11.12 (A3), U12.12 (A3), U13.12 (A3), U14.12 (A3), U15.12 (A3), U16.12 (A3), U17.12 (A3), U18.12 (A3), U19.12 (A3), U20.11 (A3), U21.12 (A3), U22.11 (A3), U23.11 (A3), U24.11 (A3)
MA4: RP2.3 (R2.1), U1.11 (A4), U2.11 (A4), U3.11 (A4), U4.11 (A4), U5.11 (A4), U6.11 (A4), U7.11 (A4), U8.11 (A4), U9.11 (A4), U10.11 (A4), U11.11 (A4), U12.11 (A4), U13.11 (A4), U14.11 (A4), U15.11 (A4), U16.11 (A4), U17.11 (A4), U18.11 (A4), U19.11 (A4), U20.8 (A4), U21.11 (A4), U22.8 (A4), U23.8 (A4), U24.8 (A4)
MA5: RP2.8 (R4.2), U1.10 (A5), U2.10 (A5), U3.10 (A5), U4.10 (A5), U5.10 (A5), U6.10 (A5), U7.10 (A5), U8.10 (A5), U9.10 (A5), U10.10 (A5), U11.10 (A5), U12.10 (A5), U13.10 (A5), U14.10 (A5), U15.10 (A5), U16.10 (A5), U17.10 (A5), U18.10 (A5), U19.10 (A5), U20.7 (A5), U21.10 (A5), U22.7 (A5), U23.7 (A5), U24.7 (A5)
MA6: RP2.5 (R3.1), U1.13 (A6), U2.13 (A6), U3.13 (A6), U4.13 (A6), U5.13 (A6), U6.13 (A6), U7.13 (A6), U8.13 (A6), U9.13 (A6), U10.13 (A6), U11.13 (A6), U12.13 (A6), U13.13 (A6), U14.13 (A6), U15.13 (A6), U16.13 (A6), U17.13 (A6), U18.13 (A6), U19.13 (A6), U20.6 (A6), U21.13 (A6), U22.6 (A6), U23.6 (A6), U24.6 (A6)
MA7: RP2.1 (R1.1), U1.9 (A7), U2.9 (A7), U3.9 (A7), U4.9 (A7), U5.9 (A7), U6.9 (A7), U7.9 (A7), U8.9 (A7), U9.9 (A7), U10.9 (A7), U11.9 (A7), U12.9 (A7), U13.9 (A7), U14.9 (A7), U15.9 (A7), U16.9 (A7), U17.9 (A7), U18.9 (A7), U19.9 (A7), U20.10 (A7), U21.9 (A7), U22.10 (A7), U23.10 (A7), U24.10 (A7)
MA8: RP5.1 (R1.1), U1.1 (A8), U2.1 (A8), U3.1 (A8), U4.1 (A8), U5.1 (A8), U6.1 (A8), U7.1 (A8), U8.1 (A8), U9.1 (A8), U10.1 (A8), U11.1 (A8), U12.1 (A8), U13.1 (A8), U14.1 (A8), U15.1 (A8), U16.1 (A8), U17.1 (A8), U18.1 (A8)
MD0: RR3.9 (R8), U4.2 (Din), U4.14 (Dout), U14.2 (Din), U14.14 (Dout), U20.2 (D1), U23.2 (D1), U28.11 (B7)
MD1: RR3.8 (R7), U3.2 (Din), U3.14 (Dout), U13.2 (Din), U13.14 (Dout), U20.3 (D2), U23.3 (D2), U28.12 (B6)
MD2: RR3.7 (R6), U2.2 (Din), U2.14 (Dout), U12.2 (Din), U12.14 (Dout), U20.15 (D3), U23.15 (D3), U28.13 (B5)
MD3: RR3.6 (R5), U1.2 (Din), U1.14 (Dout), U11.2 (Din), U11.14 (Dout), U20.17 (D4), U23.17 (D4), U28.14 (B4)
MD4: RR3.5 (R4), U9.2 (Din), U9.14 (Dout), U18.2 (Din), U18.14 (Dout), U22.2 (D1), U24.2 (D1), U28.15 (B3)
MD5: RR3.4 (R3), U8.2 (Din), U8.14 (Dout), U17.2 (Din), U17.14 (Dout), U22.3 (D2), U24.3 (D2), U28.16 (B2)
MD6: RR3.3 (R2), U7.2 (Din), U7.14 (Dout), U16.2 (Din), U16.14 (Dout), U22.15 (D3), U24.15 (D3), U28.17 (B1)
MD7: RR3.2 (R1), U6.2 (Din), U6.14 (Dout), U15.2 (Din), U15.14 (Dout), U22.17 (D4), U24.17 (D4), U28.18 (B0)
NMI: U39.31 (NMI), U40.17 (NMI)
unnamed: C21.1, J1.1, J11.1 (A), R2.2, U47.1
unnamed: C22.1, Q1.3 (C), R1.2
unnamed: C46.1, OSC1.8 (OUT), R11.1, U39.23 (X1), X1.2
unnamed: J2.2, R1.1
unnamed: J3.2, R9.2, U44.5
unnamed: J4.2, R10.2, U44.9
unnamed: J5.2, R5.1
unnamed: J6.2, R4.1
unnamed: J7.2 (B), R7.2, U39.13 (VID1)
unnamed: J8.2 (B), R6.2, U39.12 (VID0)
unnamed: J9.2 (B), R8.2, U35.1 (VPP)
unnamed: J10.2 (B), R3.2, U35.27 (A14)
unnamed: Q1.2 (B), U31.6
unnamed: R4.2, U46.5 (Q)
unnamed: R5.2, U46.9 (Q)
unnamed: R11.2, U39.21 (X2), X1.1
unnamed: RP1.2 (R1.2), U25.12 (Zc)
unnamed: RP1.4 (R2.2), U25.4 (Za)
unnamed: RP1.6 (R3.2), U25.7 (Zb)
unnamed: RP1.7 (R4.1), U25.9 (Zd)
unnamed: RP2.2 (R1.2), U26.12 (Zc)
unnamed: RP2.4 (R2.2), U26.4 (Za)
unnamed: RP2.6 (R3.2), U26.9 (Zd)
unnamed: RP2.7 (R4.1), U26.7 (Zb)
unnamed: RP4.2 (R1.2), U29.12
unnamed: RP4.4 (R2.2), U30.11
unnamed: RP4.6 (R3.2), U30.8
unnamed: RP4.7 (R4.1), U29.8
unnamed: RP5.2 (R1.2), U27.4 (Za)
unnamed: RP5.3 (R2.1), U31.12
unnamed: RP5.5 (R3.1), U31.10
unnamed: RP5.8 (R4.2), U31.8
unnamed: U29.11, U31.4
unnamed: U30.3, U45.1
unnamed: U30.4, U30.5, U42.12
unnamed: U30.6, U45.2, U45.13
unnamed: U42.2, U42.6
unnamed: U42.9, U43.1
unnamed: U42.10, U43.4
unnamed: U42.11, U43.10
unnamed: U42.8, U42.13
unnamed: U44.4, U44.10, U45.6
unnamed: U45.3, U45.4
unnamed: U45.8, U46.3 (C), U46.11 (C)
unnamed: U45.10, U45.11
unnamed: U47.2, U47.3
unnamed: U47.4, U47.5
unnamed: U47.9, U47.10
unnamed: U47.11, U47.12
unnamed: U47.6, U47.13
OSC: U39.20 (OSC), U41.13 (I1b)
OSCDRV: BUS1.30 (OSC), BUS2.30 (OSC), BUS3.30 (OSC), BUS4.30 (OSC), BUS5.30 (OSC), BUS6.30 (OSC), BUS7.30 (OSC), U41.7 (O1b)
PTYIN: U5.14 (Dout), U10.14 (Dout), U19.14 (Dout), U21.14 (Dout), U39.32 (PTYIN)
PTYOUT: U5.2 (Din), U10.2 (Din), U19.2 (Din), U21.2 (Din), U38.3 (O3b)
QS0: U36.25 (QS0), U40.25 (QS0)
QS1: U36.24 (QS1), U40.24 (QS1)
READY: U36.22 (READY), U39.17 (READY), U40.22 (READY)
RESET: U39.18 (RESET), U41.17 (I3b)
RS0: U30.12, U31.13, U39.83 (RS0)
RS1: U30.9, U31.11, U39.84 (RS1)
RS2: U29.1, U29.9, U31.9, U39.3 (RS2)
RSTDRV: BUS1.2 (RESET), BUS2.2 (RESET), BUS3.2 (RESET), BUS4.2 (RESET), BUS5.2 (RESET), BUS6.2 (RESET), BUS7.2 (RESET), U31.1, U36.21 (RESET), U40.21 (RESET), U41.3 (O3b)
SLAD: U25.1 (S), U26.1 (S), U27.1 (S), U39.8 (SLAD)
SPKR: U31.5, U39.14 (SPEAKR)
TC: BUS1.27 (TC), BUS2.27 (TC), BUS3.27 (TC), BUS4.27 (TC), BUS5.27 (TC), BUS6.27 (TC), BUS7.27 (TC), U41.9 (O0b)
UNUSED: BUS1.8 (UNUSED), BUS2.8 (UNUSED), BUS3.8 (UNUSED), BUS4.8 (UNUSED), BUS5.8 (UNUSED), BUS6.8 (UNUSED), BUS7.8 (UNUSED)
VCC: BUS1.3 (VCC), BUS1.29 (VCC), BUS2.3 (VCC), BUS2.29 (VCC), BUS3.3 (VCC), BUS3.29 (VCC), BUS4.3 (VCC), BUS4.29 (VCC), BUS5.3 (VCC), BUS5.29 (VCC), BUS6.3 (VCC), BUS6.29 (VCC), BUS7.3 (VCC), BUS7.29 (VCC), C3.1, C4.1, C5.1, C6.1, C7.1, C8.1, C9.1, C10.1, C11.1, C12.1, C13.1, C14.1, C15.1, C16.1, C17.1, C18.1, C19.1, C20.1, C23.1, C24.1, C25.1, C26.1, C27.1, C28.1, C29.1, C30.1, C31.1, C32.1, C33.1, C34.1, C35.1, C36.1, C37.1, C38.1, C39.1, C40.1, C41.1, C42.1, C43.1, C44.1, C45.1, C47.1, C48.1, C49.1, C50.1, C52.1, J2.1, OSC1.14 (Vcc), P1.5, P2.2, P2.10, P2.11, P2.12, R2.1, R3.1, R6.1, R7.1, R8.1, R9.1, R10.1, R12.2, R13.2, RP6.1 (common), RR3.1 (common), U1.8 (VCC), U2.8 (VCC), U3.8 (VCC), U4.8 (VCC), U5.8 (VCC), U6.8 (VCC), U7.8 (VCC), U8.8 (VCC), U9.8 (VCC), U10.8 (VCC), U11.8 (VCC), U12.8 (VCC), U13.8 (VCC), U14.8 (VCC), U15.8 (VCC), U16.8 (VCC), U17.8 (VCC), U18.8 (VCC), U19.8 (VCC), U20.9 (VCC), U21.8 (VCC), U22.9 (VCC), U23.9 (VCC), U24.9 (VCC), U25.16 (VCC), U26.16 (VCC), U27.16 (VCC), U28.20 (VCC), U29.14 (VCC), U30.14 (VCC), U31.14 (VCC), U32.16 (VCC), U33.20 (VCC), U34.20 (VCC), U35.28 (VCC), U36.40 (VCC), U37.20 (VCC), U38.20 (VCC), U39.1 (VCC), U39.43 (VCC), U40.40 (VCC), U41.20 (VCC), U42.14 (VCC), U43.14 (VCC), U44.14 (VCC), U45.14 (VCC), U46.1 (~R), U46.4 (~S), U46.10 (~S), U46.13 (~R), U46.14 (VCC), U47.14 (VDD)
XAEN: U38.13 (I1b), U39.30 (AEN)
XALE: U38.2 (I0a), U39.69 (BALE)
XPTYOUT: U38.17 (I3b), U39.33 (PTYOUT)
~CAS0: RP4.3 (R2.1), U1.15 (~CAS), U2.15 (~CAS), U3.15 (~CAS), U4.15 (~CAS), U5.15 (~CAS), U6.15 (~CAS), U7.15 (~CAS), U8.15 (~CAS), U9.15 (~CAS)
~CAS1: RP4.5 (R3.1), U10.15 (~CAS), U11.15 (~CAS), U12.15 (~CAS), U13.15 (~CAS), U14.15 (~CAS), U15.15 (~CAS), U16.15 (~CAS), U17.15 (~CAS), U18.15 (~CAS)
~CAS2: RP4.8 (R4.2), U19.15 (~CAS), U20.16 (~CAS), U22.16 (~CAS)
~CAS3: RP4.1 (R1.1), U21.15 (~CAS), U23.16 (~CAS), U24.16 (~CAS)
~DACK0: BUS1.19 (DACK0), BUS2.19 (DACK0), BUS3.19 (DACK0), BUS4.19 (DACK0), BUS5.19 (DACK0), BUS6.19 (DACK0), BUS7.19 (DACK0), U41.18 (O0a)
~DACK1: BUS1.17 (DACK1), BUS2.17 (DACK1), BUS3.17 (DACK1), BUS4.17 (DACK1), BUS5.17 (DACK1), BUS6.17 (DACK1), BUS7.17 (DACK1), U41.16 (O1a)
~DACK2: BUS1.26 (DACK2), BUS2.26 (DACK2), BUS3.26 (DACK2), BUS4.26 (DACK2), BUS5.26 (DACK2), BUS6.26 (DACK2), BUS7.26 (DACK2), U41.14 (O2a)
~DACK3: BUS1.15 (DACK3), BUS2.15 (DACK3), BUS3.15 (DACK3), BUS4.15 (DACK3), BUS5.15 (DACK3), BUS6.15 (DACK3), BUS7.15 (DACK3), U41.12 (O3a)
~DEN: U37.19 (CE), U39.71 (~DEN)
~EPSL: U35.22 (~OE), U39.6 (~EPSL)
~IOCHK: BUS1.32 (IO_CH_CK), BUS2.32 (IO_CH_CK), BUS3.32 (IO_CH_CK), BUS4.32 (IO_CH_CK), BUS5.32 (IO_CH_CK), BUS6.32 (IO_CH_CK), BUS7.32 (IO_CH_CK), R13.1, U39.27 (~IOCHK)
~IOR: BUS1.14 (IOR), BUS2.14 (IOR), BUS3.14 (IOR), BUS4.14 (IOR), BUS5.14 (IOR), BUS6.14 (IOR), BUS7.14 (IOR), U38.9 (O0b), U45.5
~IOW: BUS1.13 (IOW), BUS2.13 (IOW), BUS3.13 (IOW), BUS4.13 (IOW), BUS5.13 (IOW), BUS6.13 (IOW), BUS7.13 (IOW), U38.12 (O3a), U45.9
~MEMR: BUS1.12 (MEMR), BUS2.12 (MEMR), BUS3.12 (MEMR), BUS4.12 (MEMR), BUS5.12 (MEMR), BUS6.12 (MEMR), BUS7.12 (MEMR), U38.14 (O2a)
~MEMW: BUS1.11 (MEMW), BUS2.11 (MEMW), BUS3.11 (MEMW), BUS4.11 (MEMW), BUS5.11 (MEMW), BUS6.11 (MEMW), BUS7.11 (MEMW), U38.16 (O1a)
~MWE: U1.3 (~WE), U2.3 (~WE), U3.3 (~WE), U4.3 (~WE), U5.3 (~WE), U6.3 (~WE), U7.3 (~WE), U8.3 (~WE), U9.3 (~WE), U10.3 (~WE), U11.3 (~WE), U12.3 (~WE), U13.3 (~WE), U14.3 (~WE), U15.3 (~WE), U16.3 (~WE), U17.3 (~WE), U18.3 (~WE), U19.3 (~WE), U20.4 (~WE), U21.3 (~WE), U22.4 (~WE), U23.4 (~WE), U24.4 (~WE), U38.5 (O2b)
~RAMCS: U28.19 (CE), U39.5 (~RAMCS)
~RAS0: RP5.4 (R2.2), U1.4 (~RAS), U2.4 (~RAS), U3.4 (~RAS), U4.4 (~RAS), U5.4 (~RAS), U6.4 (~RAS), U7.4 (~RAS), U8.4 (~RAS), U9.4 (~RAS)
~RAS1: RP5.6 (R3.2), U10.4 (~RAS), U11.4 (~RAS), U12.4 (~RAS), U13.4 (~RAS), U14.4 (~RAS), U15.4 (~RAS), U16.4 (~RAS), U17.4 (~RAS), U18.4 (~RAS)
~RAS2: RP5.7 (R4.1), U19.4 (~RAS), U20.5 (~RAS), U21.4 (~RAS), U22.5 (~RAS), U23.5 (~RAS), U24.5 (~RAS)
~RESET: C51.1, P1.3, U31.2
~RESIN: J11.2 (B), U39.15 (~REST), U47.8
~RQ/GT0: RP6.2 (R1), U39.24 (~RQ/GT), U40.31 (~RQ~/~GT0~)
~RQ/GT1: RP6.4 (R3), U36.31 (~RQ~/~GT0~), U40.30 (~RQ~/~GT1~)
~RQ/GT2: RP6.3 (R2), U36.33 (~RQ~/~GT1~)
~S0: RP6.7 (R6), U36.26 (~S0), U39.75 (~S0), U40.26 (~S0)
~S1: RP6.6 (R5), U36.27 (~S1), U39.74 (~S1), U40.27 (~S1)
~S2: RP6.5 (R4), U36.28 (~S2), U39.73 (~S2), U40.28 (~S2)
~TEST: RP6.8 (R7), U36.23 (BUSY), U40.23 (~TEST)
~XDACK0: U39.63 (~DACK0), U41.2 (I0a)
~XDACK1: U39.62 (~DACK1), U41.4 (I1a)
~XDACK2: U39.61 (~DACK2), U41.6 (I2a)
~XDACK3: U39.60 (~DACK3), U41.8 (I3a)
~XIOR: U38.11 (I0b), U39.65 (~IOR)
~XIOW: U38.8 (I3a), U39.66 (~IOW)
~XMEMR: U28.1 (A->B), U38.6 (I2a), U39.67 (~MEMR)
~XMEMW: U38.4 (I1a), U38.15 (I2b), U39.68 (~MEMW)

Notes on the sheet:
I/O read from: 0x073, returns J3 and J4 in bits 0,1 A9=0; A8=0; A7=0; A6=1; A5=1; A4=1; A3=0; A2=0; A1=1; A0=1 Turbo switches?
I/O write to 0x063, bits 6,7 write to J6, J5 A9=0; A8=0; A7=0; A6=1; A5=1; A4=0; A3=0; A2=0; A1=1; A0=1 Turbo LEDs?
Processor, Coprocessor, Chipset, Buffers and Address Latches
Install either OSC1 or X1/R11/C46
Turbo Switches and Turbo LEDs
BIOS ROM
DRAM Multiplexers and Buffers
Keyboard
Speaker
DRAM - Bank 0
DRAM - Bank 1
DRAM - Bank 2
ISA Slots
Logic ICs - Power Pins
Logic ICs - Spare Gates
Power and Decoupling Capacitors
Mounting Holes
