skiselev/Proton_Turbo_XT/(notices)

Notices in the files:
KiCad/Proton_Turbo_XT.sch:
Licensed under CERN-OHL-S: https://cern-ohl.web.cern.ch
